debsahu/PCF8574_8Relay/(threads)

Thread 1 (2019-04-29):

Use ESP8266 with 4 Channel Relay without PCF8574

abhishekakt1, 2019-04-29:
Hi Deb

This is exactly what I was looking for. Thanks . I want to use the code with 4 channel relay without the PCF7574. I was using ESP8266 with 4 channel relay using Blynk app but now want to hook it up using mqtt on my new home assistant server. I understand your reason using PCF8574 as few ESP pins trigger high or low. With default behavior, as soon as I power on ESP, it used to turn on all relays. I did few search and found some code and found below code with helped me achieve what I was expecting:

4 Channel relay is connected on D0, D1, D2 and D3

`void setup()
{
  // Debug console
  Serial.begin(115200);
  pinMode(16, OUTPUT); //D0 is GPIO 16
  pinMode(5, OUTPUT); //D1 is GPIO 5
  pinMode(4, OUTPUT); //D2 is GPIO 4
  pinMode(0, OUTPUT); //D3 is GPIO 0
  digitalWrite(16, HIGH); //Set GPIO 16 LOW
  digitalWrite(5, HIGH); // Set GPIO 5 LOW
  digitalWrite(4, HIGH); // Set GPIO 4 LOW
  digitalWrite(0, HIGH); // Set GPIO 0 LOW

I have put MAX DEVICES to 4 in your code with works fine but need help removing PCF7574.
`
I am not good with coding so I can request you to make help me modify the code to use it with 4 channel relay without using PCF8574?

Thank you.

debsahu, 2019-05-01:
Not so straightforward, I will have to invest more time to do this. I would use `struct` to achieve this refer: https://github.com/debsahu/CeilingPotLights No promises on timeline on doing this as I'm very busy with my day job for past few weeks.

debsahu, 2019-10-14:
Ok check out https://github.com/debsahu/PCF8574_8Relay/tree/direct_4Relay

Thread 4 (2020-01-24):

Use opto-isolation

Misiu, 2020-01-24:
The relay board has opto-isolation, so ideally it should be used to prevent damaging the ESP.
Take a look at https://forum.arduino.cc/index.php?topic=185234.msg2651260#msg2651260

I've used relay boards before, but with Raspberry. I use similar schematics to this one:
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
but two separate power sources could be used.
I'm not a professional electronic, so probably this can be improved :)

Thread 5 (2020-04-19):

MQTT Not Discovery

hostdown, 2020-04-19:
Hi, i compile the code, and all OK, but on my homeassistant installation not appear the device automatically, i have configure correctly MQTT Broker, and i have installed too zigbee2mqtt.

Im using the software MQTT Explorer and i see perfectly, and i can access to website to switch ON/OFF, i search a lot and i dont know what more can i do.
Dont receive any error, only dont discovery.

I try disable zigbee2mqtt, force discovery on configuration.yaml, and nothing appear... i dont know what more can i do.

My homeassistant version is 0.108.6 on Linux Ubuntu 18.08 Server, MQTT Broker 5.1 and zigbee2mqtt 1.12.2.

Please, help!! Thank u.

debsahu, 2020-04-19:
Did you turn on MQTT discovery on home assistant? https://www.home-assistant.io/docs/mqtt/discovery/

hostdown, 2020-04-19:
Yes i have, this lines on the configuration.yaml

discovery:
  ignore:
    - sonos
    - samsung_printer
  enable:
    - homekit

mqtt:
  broker: localhost
  discovery: true
  discovery_prefix: homeassistant

im trying all the time, making changes and nothing...
the mqtt explorer work fine, and see them

debsahu, 2020-04-19:
Check if it shows up in Configuration > Integrations > MQTT

hostdown, 2020-04-19:
Okk!! Noww!!
I dont know why, but discovery not work correctly.

I see the switches on Configuration > Entity
So... i create a new UI tab, and add a Entity Card, i select all, and thats all Ok.

Thank u for all ur help!! Thank u!!!

Closed 2020-04-20.

Thread 7 (2023-12-22):

OFF and ON Switched.

crustylarry, 2023-12-22:
My ON and OFF are switched, which line of the code can I flip to change the ON and OFF state?
