debsahu/PCF8574_8Relay/Arduino/PCF8574_8Relay/indexhtml.h

#include <pgmspace.h>

#define index_htm_gz_len 2257
static const char index_htm_gz[] PROGMEM = {
  0x1f, 0x8b, 0x08, 0x00, 0xf6, 0xaf, 0x65, 0x5c, 0x02, 0x03, 0xc5, 0x5a,
  0xff, 0x73, 0x9b, 0x38, 0x16, 0xff, 0x57, 0x08, 0xbd, 0xcb, 0xc2, 0x15,
  0x13, 0xfc, 0xdd, 0x0b, 0xc1, 0x99, 0x5c, 0x92, 0xde, 0xe4, 0xa6, 0x9b,
  0xec, 0x34, 0x9d, 0xbd, 0x1f, 0x3a, 0x9d, 0x1d, 0x19, 0x44, 0xcc, 0x15,
  0x4b, 0x0c, 0x12, 0x71, 0xb2, 0x8e, 0xef, 0x6f, 0xbf, 0x27, 0x09, 0x08,
  0x36, 0x34, 0x4e, 0xd6, 0xe9, 0x6c, 0xdb, 0xc1, 0x42, 0xd2, 0x7b, 0xef,
  0xf3, 0xbe, 0xf2, 0x04, 0x3d, 0x9e, 0xf3, 0x45, 0x32, 0x3d, 0x9e, 0x63,
  0x14, 0x4e, 0x8f, 0x19, 0x7f, 0x48, 0xf0, 0x34, 0x41, 0x33, 0x9c, 0x58,
  0x0c, 0x07, 0x3c, 0xa6, 0x64, 0x15, 0xc6, 0x2c, 0x4d, 0xd0, 0x83, 0x1b,
  0x93, 0x24, 0x26, 0xb8, 0x33, 0x4b, 0x68, 0xf0, 0x6d, 0x6d, 0x53, 0x42,
  0xa3, 0xc8, 0x9a, 0xd1, 0xf0, 0x61, 0xc5, 0xf1, 0x3d, 0xef, 0xa0, 0x24,
  0xbe, 0x25, 0x6e, 0x80, 0x09, 0xc7, 0xd9, 0x5a, 0x4e, 0x07, 0x34, 0xa1,
  0x99, 0xfb, 0x2e, 0x8a, 0x22, 0x6f, 0x86, 0x82, 0x6f, 0xb7, 0x19, 0xcd,
  0x49, 0xd8, 0x29, 0x66, 0x67, 0x3f, 0x87, 0x3f, 0x47, 0xc1, 0xda, 0x06,
  0xaa, 0x39, 0xbf, 0xe1, 0x88, 0xe7, 0x6c, 0xb5, 0x40, 0xd9, 0x6d, 0x4c,
  0x3a, 0x9c, 0xa6, 0xee, 0x30, 0xbd, 0xf7, 0x6a, 0xf4, 0x11, 0x25, 0xbc,
  0xc3, 0xe2, 0x3f, 0xb0, 0xdb, 0x1d, 0xc0, 0x8a, 0xbc, 0x8d, 0xd0, 0x22,
  0x4e, 0x1e, 0xdc, 0xdf, 0x70, 0x16, 0x22, 0x82, 0xd6, 0x36, 0x5b, 0xc6,
  0x3c, 0x98, 0x5b, 0xe9, 0x4a, 0xac, 0xba, 0x03, 0xc7, 0xd1, 0x7a, 0x4e,
  0x7a, 0x7f, 0x34, 0x80, 0x8b, 0x76, 0x9a, 0xc5, 0x28, 0xf1, 0x24, 0x4e,
  0x9e, 0x21, 0xc2, 0x22, 0x9a, 0x2d, 0xdc, 0x3c, 0x4d, 0x71, 0x16, 0x20,
  0x86, 0xbd, 0x04, 0x73, 0x40, 0xdd, 0x61, 0x29, 0x0a, 0x62, 0x72, 0xeb,
  0x76, 0xd3, 0xfb, 0x75, 0xa9, 0xbc, 0xc2, 0xe4, 0x3a, 0x5e, 0x8a, 0xc2,
  0x50, 0x2c, 0x3a, 0xde, 0x32, 0x0e, 0xf9, 0xdc, 0xed, 0x8e, 0x80, 0xf1,
  0x3a, 0x26, 0x69, 0xce, 0xbf, 0xf0, 0x87, 0x14, 0xfb, 0xc1, 0x1c, 0x07,
  0xdf, 0x66, 0xf4, 0xfe, 0x6b, 0x65, 0x30, 0x69, 0x29, 0x8f, 0x0a, 0xae,
  0xfc, 0xc1, 0x75, 0xd6, 0xd2, 0xac, 0x2b, 0x45, 0x2e, 0xa8, 0xbd, 0x39,
  0x16, 0xda, 0xbb, 0x7d, 0x31, 0x0e, 0xf2, 0x8c, 0x81, 0xba, 0x29, 0x8d,
  0x85, 0x05, 0xbd, 0x94, 0xb2, 0x58, 0x00, 0x70, 0x33, 0x9c, 0x20, 0x1e,
  0xdf, 0xe1, 0x9a, 0x0d, 0xdd, 0x77, 0x13, 0xe4, 0xc0, 0x1f, 0x6f, 0x46,
  0xb3, 0x10, 0x70, 0x67, 0x28, 0x8c, 0x73, 0xa6, 0xd8, 0x48, 0xf5, 0x14,
  0xe5, 0xb6, 0xd1, 0x35, 0x7b, 0xc0, 0xbc, 0xce, 0x82, 0xfe, 0xd1, 0xd9,
  0xb9, 0x69, 0x89, 0x67, 0xdf, 0x62, 0xbe, 0x6b, 0x9f, 0x52, 0xc8, 0x45,
  0x11, 0x00, 0x5e, 0x25, 0x38, 0xe2, 0x95, 0x71, 0x7a, 0x35, 0xed, 0xe4,
  0xb8, 0x30, 0xa3, 0x72, 0x2b, 0x28, 0x08, 0x1e, 0xfa, 0xe9, 0xa7, 0x27,
  0x25, 0xd1, 0x8c, 0xd1, 0x24, 0xe7, 0x9b, 0x4a, 0xca, 0xc0, 0xd9, 0xd0,
  0xb0, 0x5b, 0x99, 0xdc, 0x95, 0xd6, 0xc6, 0xe1, 0x7b, 0x65, 0xd3, 0x3a,
  0x99, 0xe3, 0x8c, 0x87, 0xfd, 0x6e, 0xdb, 0xb6, 0x3a, 0x52, 0x94, 0x73,
  0xea, 0x65, 0x12, 0xa0, 0xb3, 0x4e, 0xcb, 0x58, 0x9d, 0x85, 0xe2, 0xaf,
  0x57, 0x3a, 0x90, 0x50, 0x82, 0xcb, 0xc0, 0x2a, 0xb7, 0x08, 0xbb, 0x97,
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
};
