debsahu/PCF8574_8Relay/(notices)

Notices in the files:
README.md:
License: MIT
